yunchencui-hub/DT-smart-system/video-remotion/review/anatomy-script.md

# Review copy of the Robin anatomy + ELI5 build video (generated)

Generated by `scripts/review.ts --script anatomy` from the same data the video renders (`src/anatomy/script.ts`, `src/data/wiring.ts`). **Do not edit by hand.**
Each spoken line shows the cable state while it is spoken: 🔌 **USB OUT** (Arduino unplugged: the only state in which we wire), ⚡ **USB IN** (testing), 💽 **MICRO** (Arduino unplugged, voice module alone on its micro-USB cable).
"adds" = the parts or wires that appear on the workbench drawing during that line, with their exact holes.

## Build Robin: the anatomy, step by step  `a-title`
*Welcome*

1. [🔌 USB OUT] This is Robin, a small care robot. In this video we build it, one step at a time.
2. [🔌 USB OUT] Every picture is a drawing of the parts you received, and every part sits exactly where it goes on your bench.
3. [🔌 USB OUT] We follow the assembly guide, file 04, and for each step you hear what to do and why it works, in plain words.

On-screen text:
- `title`: Build Robin
- `sub`: The anatomy of the build, step by step · follows docs/04
- `badge`: DRAWING · not real footage

## What came in the box  `a-kit`
*1 · Get ready*

1. [🔌 USB OUT] First, check what you received. Tick off every part, and if something is missing, tell the store room before you start.
2. [🔌 USB OUT] Think of Robin as a body. The Arduino is the brain. It reads the sensors, and its grid of little lights is Robin's face.
3. [🔌 USB OUT] The motion sensor and the light sensor are its eyes. The two buttons are its ears: green means yes, red means no.
4. [🔌 USB OUT] The voice module and the speaker are its mouth. The breadboard and the jumper wires are its nerves: they connect everything.
5. [🔌 USB OUT] The capacitor is a small water tank for electricity. And the box with the clear lid is Robin's skin.
6. [🔌 USB OUT] Some parts come with a spare: two light sensors, two capacitors, two speakers, three buttons. Keep the spares in the bag.

On-screen text:
- `brain`: brain + face
- `senses`: eyes + ears
- `mouth`: mouth + nerves
- `tank`: water tank + skin
- `note`: Renders of the parts we received (video-assets/parts/)

## Three rules before you build  `a-rules`
*1 · Get ready*

1. [🔌 USB OUT] Before step one, upload the firmware in offline test mode, as in file 05. Then no WiFi is needed yet.
   - *spoken:* "Before step one, upload the firmware in offline test mode, as in file 05. Then no Wi-Fi is needed yet."
2. [🔌 USB OUT] Rule one, the golden rule: wire only while the USB cable is unplugged. Plug in only to test, and unplug again after every test.
   - *spoken:* "Rule one, the golden rule: wire only while the U S B cable is unplugged. Plug in only to test, and unplug again after every test."
3. [🔌 USB OUT] Rule two: work on cardboard or wood, never on metal or on your laptop. The pins under the boards are bare, and metal would connect them.
4. [🔌 USB OUT] Rule three: read the label, not the picture. Pin order can differ between versions of a module, so always go by the names printed on your own part.
5. [🔌 USB OUT] Three things have a plus and a minus, and do damage when they are reversed: the module's power pins, the capacitor, and the breadboard rails. Check them twice.
6. [🔌 USB OUT] After every step there is a test. Don't continue until it passes. One new mistake is easy to find. Six at once is misery.

Figure card: Fig 1 · The bench · readout: nothing wired yet

ELI5 card: Wire unplugged. Test plugged in. Unplug again.

## Inside the breadboard  `a-breadboard`
*1 · Get ready*

1. [🔌 USB OUT] Now the breadboard. It looks like a field of holes, but inside it is simple.
2. [🔌 USB OUT] Lift off the plastic, and you see metal clips. Each clip connects a few holes into one group.
3. [🔌 USB OUT] Each short column of five holes is one group. Two legs in the same group are connected.
   - *glows:* col:5:bottom
4. [🔌 USB OUT] The middle gap splits every column into a top half and a bottom half, and the two halves are not connected.
   - *glows:* col:5:bottom, col:5:top
5. [🔌 USB OUT] Along the long sides run the rails. Every hole along the red line is connected: that is the plus rail, 5 volts. Every hole along the blue line is the minus rail, ground.
   - *glows:* rail:+b, rail:-b
6. [🔌 USB OUT] The two pairs of rails are not connected to each other. We only use the pair next to the Arduino's power pins.
   - *glows:* rail:+b, rail:-b
7. [🔌 USB OUT] Some boards put the red line on the outside, others on the inside. Always follow the red and blue lines printed on your own board.
8. [🔌 USB OUT] If a line has a break in the middle, that rail is split in two. Join the halves with a short wire: plus to plus, minus to minus, never red to blue.

Figure card: Fig 2 · Breadboard, x-ray · hint: the plastic lifted off · readout: 30 columns · 4 rails

ELI5 card: Holes in the same metal clip are connected. Different clips are not.

## Step 1 · Power rails  `a-step1`
*2 · Build*

1. [🔌 USB OUT] Step one: power. The brain shares its power with the breadboard.
2. [🔌 USB OUT] With the USB cable unplugged, connect the Arduino's 5V pin to the plus rail, the red line.
   - *spoken:* "With the U S B cable unplugged, connect the Arduino's five volt pin to the plus rail, the red line."
   - *glows:* pin:5V, rail:+b
   - *adds* `w5v`: Arduino 5V → + rail. (M-M, red: Arduino 5V → + rail (col 2))
3. [🔌 USB OUT] Then connect GND to the minus rail, the blue line.
   - *spoken:* "Then connect G N D to the minus rail, the blue line."
   - *glows:* pin:GND, rail:-b
   - *adds* `wgnd`: Arduino GND → − rail. (M-M, black: Arduino GND → − rail (col 1))
4. [🔌 USB OUT] Now the whole red line carries 5 volts, and the whole blue line is ground. Every part can take its power there, like plugging into a power strip.
   - *glows:* rail:+b, rail:-b
5. [⚡ USB IN] Test: plug in the USB cable. The power LED comes on. The face shows crossed eyes for a moment while it starts, then a happy face.
   - *spoken:* "Test: plug in the U S B cable. The power L E D comes on. The face shows crossed eyes for a moment while it starts, then a happy face."
6. [🔌 USB OUT] Unplug.

Figure card: Fig 3 · Step 1 · Power

ELI5 card: The rails are a power strip: every part can plug in there.

Parts shown (renders): dupont_mm_200mm

## Step 2 · Light sensor (LDR)  `a-step2`
*2 · Build*

1. [🔌 USB OUT] Step two: the light sensor, Robin's eye for light.
2. [🔌 USB OUT] The Arduino can't measure resistance. It can only measure voltage. So we build a voltage divider.
3. [🔌 USB OUT] Push one leg of the LDR into the plus rail, and the other leg into column 5, in the bottom half.
   - *spoken:* "Push one leg of the L D R into the plus rail, and the other leg into column five, in the bottom half."
   - *glows:* rail:+b, col:5:bottom
   - *adds* `ldr`: LDR: one leg in the + rail, the other in column 5 (bottom half). (a: + rail (col 3); b: column 5, row i)
4. [🔌 USB OUT] Which resistor is 10 kΩ? Read the label on its bag. Keep the 1 kΩ bag closed for now.
   - *spoken:* "Which resistor is ten kilo-ohm? Read the label on its bag. Keep the one kilo-ohm bag closed for now."
5. [🔌 USB OUT] Put the 10 kΩ resistor from column 5 to the minus rail. The LDR and the resistor have no plus or minus, so either way round is fine.
   - *spoken:* "Put the ten kilo-ohm resistor from column five to the minus rail. The L D R and the resistor have no plus or minus, so either way round is fine."
   - *glows:* col:5:bottom, rail:-b
   - *adds* `r10k`: 10 kΩ: one leg in column 5, the other in the − rail. (a: column 5, row g; b: − rail (col 9))
6. [🔌 USB OUT] Then a wire from column 5 to the Arduino's A0 pin.
   - *spoken:* "Then a wire from column five to the Arduino's A zero pin."
   - *glows:* col:5:bottom, pin:A0
   - *adds* `wA0`: column 5 → Arduino A0. (M-M, yellow: column 5, row f (bottom half) → Arduino A0)
7. [🔌 USB OUT] Why this works: the LDR and the resistor share the 5 volts, and the bigger one takes the bigger share. In the dark the LDR is huge, so A0 sees almost nothing. In light the LDR shrinks, and A0 rises.
   - *spoken:* "Why this works: the L D R and the resistor share the 5 volts, and the bigger one takes the bigger share. In the dark the L D R is huge, so A zero sees almost nothing. In light the L D R shrinks, and A zero rises."
   - *glows:* col:5:bottom
8. [🔌 USB OUT] Predict: when you cover the LDR with your finger, does light_raw go up, or down?
   - *spoken:* "Predict: when you cover the L D R with your finger, does light raw go up, or down?"
9. [🔌 USB OUT] ⏸ pause 2.5 s: Predict: cover the LDR → light_raw goes up or down?
10. [⚡ USB IN] Test: plug in, open the Serial Monitor at 115200 baud, type raw and press Enter.
   - *spoken:* "Test: plug in, open the Serial Monitor at one hundred fifteen thousand two hundred baud, type raw and press Enter."
   - *Serial Monitor shows:* `> raw` · `[cmd] raw` · `pir_raw=4 (HIGH if > 400)  light_raw=431  yes=-  no=-` · `pir_raw=3 (HIGH if > 400)  light_raw=428  yes=-  no=-`
11. [⚡ USB IN] Cover the LDR: light_raw drops a lot. Shine your phone torch on it: it rises. So the answer was: down.
   - *spoken:* "Cover the L D R: light raw drops a lot. Shine your phone torch on it: it rises. So the answer was: down."
   - *Serial Monitor shows:* `pir_raw=5 (HIGH if > 400)  light_raw=38  yes=-  no=-` · `pir_raw=4 (HIGH if > 400)  light_raw=31  yes=-  no=-` · `pir_raw=3 (HIGH if > 400)  light_raw=874  yes=-  no=-` · `pir_raw=4 (HIGH if > 400)  light_raw=902  yes=-  no=-`
12. [🔌 USB OUT] Unplug.

Figure card: Fig 4 · Step 2 · Light

ELI5 card: Two resistors share 5 volts. The bigger one takes the bigger share.

Parts shown (renders): ldr_gl5528, resistor_10k_quarter_watt, dupont_mm_200mm

## Step 3 · PIR motion sensor  `a-step3`
*2 · Build*

1. [🔌 USB OUT] Step three: the motion sensor, Robin's eye for movement. It notices warm bodies that move.
2. [🔌 USB OUT] Gently pull off the white dome to read the pin labels: VCC, OUT and GND. Then put the dome back.
   - *spoken:* "Gently pull off the white dome to read the pin labels: V C C, OUT and G N D. Then put the dome back."
3. [🔌 USB OUT] On your board the order may be different. Go by the labels you read there, not by this drawing.
4. [🔌 USB OUT] On the back are two knobs. Turn the time knob, Tx, fully counter-clockwise: the shortest time, about 3 seconds.
   - *spoken:* "On the back are two knobs. Turn the time knob, T x, fully counter-clockwise: the shortest time, about three seconds."
   - *adds* `pir`: PIR motion sensor (HC-SR501), off the board. (off the breadboard)
5. [🔌 USB OUT] Set the sensitivity knob, Sx, to the middle. If there is a jumper, put it on H, so the output stays high while you keep moving.
   - *spoken:* "Set the sensitivity knob, S x, to the middle. If there is a jumper, put it on H, so the output stays high while you keep moving."
6. [🔌 USB OUT] Knobs not labelled? Turn both fully counter-clockwise, then turn one back to the middle. If pir_raw stays high for minutes in the test, unplug and swap them.
   - *spoken:* "Knobs not labelled? Turn both fully counter-clockwise, then turn one back to the middle. If P I R raw stays high for minutes in the test, unplug and swap them."
7. [🔌 USB OUT] Now three male to female wires: the female end goes onto the PIR pin, the male end into the breadboard or the Arduino.
   - *spoken:* "Now three male to female wires: the female end goes onto the P I R pin, the male end into the breadboard or the Arduino."
8. [🔌 USB OUT] VCC to the plus rail.
   - *spoken:* "V C C to the plus rail."
   - *glows:* rail:+b
   - *adds* `wPV`: PIR VCC → + rail. (F-M, red: PIR VCC → + rail (col 29))
9. [🔌 USB OUT] GND to the minus rail.
   - *spoken:* "G N D to the minus rail."
   - *glows:* rail:-b
   - *adds* `wPG`: PIR GND → − rail. (F-M, black: PIR GND → − rail (col 30))
10. [🔌 USB OUT] And OUT to A1.
   - *spoken:* "And OUT to A one."
   - *glows:* pin:A1
   - *adds* `wPO`: PIR OUT → Arduino A1. (F-M, orange: PIR OUT → Arduino A1)
11. [🔌 USB OUT] Why A1, an analog pin? The PIR says yes with 3.3 volts. On a digital pin the Arduino only reliably hears a yes above about 3.5 volts, so 3.3 volts is a whisper it might miss.
   - *spoken:* "Why A one, an analog pin? The P I R says yes with three point three volts. On a digital pin the Arduino only reliably hears a yes above about 3.5 volts, so three point three volts is a whisper it might miss."
   - *glows:* pin:A1
12. [🔌 USB OUT] On an analog pin, 3.3 volts reads as about 675 out of 1023, far above our threshold of 400.
   - *spoken:* "On an analog pin, three point three volts reads as about six hundred and seventy-five out of ten twenty-three, far above our threshold of four hundred."
   - *glows:* pin:A1
13. [⚡ USB IN] Test: plug in and wait 60 seconds. A PIR has to warm up, and gives random output at first.
   - *spoken:* "Test: plug in and wait sixty seconds. A P I R has to warm up, and gives random output at first."
   - *Serial Monitor shows:* `> raw` · `[cmd] raw`
14. [⚡ USB IN] Type raw. Sit still, and pir_raw is about 0. Wave, and it is about 650 to 700.
   - *spoken:* "Type raw. Sit still, and P I R raw is about zero. Wave, and it is about six hundred and fifty to seven hundred."
   - *Serial Monitor shows:* `pir_raw=3 (HIGH if > 400)  light_raw=433  yes=-  no=-` · `pir_raw=2 (HIGH if > 400)  light_raw=430  yes=-  no=-` · `pir_raw=671 (HIGH if > 400)  light_raw=431  yes=-  no=-` · `pir_raw=668 (HIGH if > 400)  light_raw=429  yes=-  no=-`
15. [🔌 USB OUT] Unplug.

Figure card: Fig 5 · Step 3 · Motion

ELI5 card: It notices warm bodies that move, and says "yes" with 3.3 volts.

Parts shown (renders): hc_sr501_pir, dupont_mf_200mm

## Step 4 · Yes and no buttons  `a-step4`
*2 · Build*

1. [🔌 USB OUT] Step four: the yes and no buttons, Robin's ears.
2. [🔌 USB OUT] A button has four legs, but only two connections: inside, the legs are joined in two pairs. This trips most people up.
3. [🔌 USB OUT] The trick that always works: put the button across the middle gap, and use two diagonally opposite legs.
4. [🔌 USB OUT] Press the green button in across the gap: its legs land in columns 11 and 13, rows d and g. Press firmly. If a leg won't go in, straighten it gently with pliers.
   - *spoken:* "Press the green button in across the gap: its legs land in columns eleven and thirteen, rows d and g. Press firmly. If a leg won't go in, straighten it gently with pliers."
   - *adds* `btnG`: green (YES) button across the gap, legs in columns 11 and 13. (tl: column 11, row d; tr: column 13, row d; bl: column 11, row g; br: column 13, row g)
5. [🔌 USB OUT] A wire from column 11, top half, to the Arduino's D2 pin.
   - *spoken:* "A wire from column eleven, top half, to the Arduino's D two pin."
   - *glows:* col:11:top, pin:D2
   - *adds* `wD2`: column 11 (top half) → Arduino D2. (M-M, green: column 11, row b (top half) → Arduino D2)
6. [🔌 USB OUT] From the diagonally opposite leg, column 13 in the bottom half, a wire to the minus rail.
   - *spoken:* "From the diagonally opposite leg, column thirteen in the bottom half, a wire to the minus rail."
   - *glows:* col:13:bottom, rail:-b
   - *adds* `wGG`: column 13 (bottom half, the diagonal leg) → − rail. (M-M, black: column 13, row i (bottom half) → − rail (col 14))
7. [🔌 USB OUT] The red button goes in columns 17 and 19: column 17, top half, to D3. Column 19, bottom half, to the minus rail.
   - *spoken:* "The red button goes in columns seventeen and nineteen: column seventeen, top half, to D three. Column nineteen, bottom half, to the minus rail."
   - *glows:* pin:D3
   - *adds* `btnR`: red (NO) button across the gap, legs in columns 17 and 19. (tl: column 17, row d; tr: column 19, row d; bl: column 17, row g; br: column 19, row g)
   - *adds* `wD3`: column 17 (top half) → Arduino D3. (M-M, purple: column 17, row b (top half) → Arduino D3)
   - *adds* `wGR`: column 19 (bottom half, the diagonal leg) → − rail. (M-M, black: column 19, row i (bottom half) → − rail (col 20))
8. [🔌 USB OUT] A button never goes to the plus rail: only to the minus rail and a D pin. Then put the caps on.
   - *glows:* rail:-b
9. [🔌 USB OUT] Why: inside the Arduino, a pull-up resistor keeps the pin at 5 volts, a HIGH, while nobody presses. Pressing connects the pin to ground, so it reads LOW. It looks backwards, but it saves a resistor.
   - *glows:* pin:D2,D3
10. [🔌 USB OUT] Predict: while you hold the green button, does D2 read HIGH, or LOW?
   - *spoken:* "Predict: while you hold the green button, does D two read HIGH, or LOW?"
11. [🔌 USB OUT] ⏸ pause 2.5 s: Predict: green held → D2 reads HIGH or LOW?
12. [⚡ USB IN] Test: plug in and type raw. While you hold green, it shows yes equals pressed: the pin reads LOW.
   - *Serial Monitor shows:* `> raw` · `[cmd] raw` · `pir_raw=2 (HIGH if > 400)  light_raw=430  yes=-  no=-` · `pir_raw=3 (HIGH if > 400)  light_raw=431  yes=pressed  no=-`
13. [⚡ USB IN] Pressing also shows a tick or a cross on the face, and the Serial Monitor prints button yes, or button no.
   - *Serial Monitor shows:* `[button] yes` · `[button] no`
14. [🔌 USB OUT] Unplug.

Figure card: Fig 6 · Step 4 · Buttons

ELI5 card: Pressed connects the pin to ground: pressed reads LOW.

Parts shown (renders): tactile_switch_with_green_cap, tactile_switch_with_red_cap, dupont_mm_200mm

## Step 5a · The speaker (the only soldering)  `a-step5a`
*2 · Build*

1. [🔌 USB OUT] Step five is the voice, in four parts: the speaker, the sound files, the wiring, and the capacitor.
2. [🔌 USB OUT] Part a, the speaker. This is the only soldering in the project: two joints.
3. [🔌 USB OUT] Safety glasses on. Solder at Pulsed with the iron in its stand, in a ventilated spot. Hold the wire with tape, not your fingers. Never touch the tip, and if the iron falls, let it fall.
4. [🔌 USB OUT] The speaker set has two speakers, and their four wires end in one white plug. Cut the wires right behind the plug.
5. [🔌 USB OUT] Careful: that four-pin plug also fits the voice module's Gravity socket. Never plug it in there. Cut it off.
6. [🔌 USB OUT] Follow the wires back to find the two that belong to the speaker you will use. Never connect both speakers. Tape each bare end of the spare separately.
7. [🔌 USB OUT] Here is the voice module, the DFR0534, lying flat on the table.
   - *spoken:* "Here is the voice module, the D F R zero five three four, lying flat on the table."
   - *adds* `voice`: DFR0534 voice module, off the board, lying flat away from the Arduino. (off the breadboard)
8. [🔌 USB OUT] Strip 5 millimetres of your speaker's two wires and twist the strands.
   - *spoken:* "Strip five millimetres of your speaker's two wires and twist the strands."
   - *adds* `spk`: one speaker of the 2 W set (the other is a spare with taped wire ends). (off the breadboard)
9. [🔌 USB OUT] Solder them into the SP+ and SP− holes, at the end of the row that starts with ONE. Red goes to SP+.
   - *spoken:* "Solder them into the S P plus and S P minus holes, at the end of the row that starts with ONE. Red goes to S P plus."
   - *glows:* vhole:SP+,SP−
   - *adds* `wSPp`: speaker + (red) → DFR0534 SP+ hole (bottom row, last; soldered in step 5a). (speaker wire, red: speaker + → DFR0534 SP+)
   - *adds* `wSPm`: speaker − (black) → DFR0534 SP− hole (bottom row, next to SP+; soldered in step 5a). (speaker wire, black: speaker − → DFR0534 SP−)
10. [🔌 USB OUT] No solder may reach the next hole, DACL, or join SP+ to SP−. Never solder the speaker to VCC, GND, RX, TX, BUSY or a DAC hole.
   - *spoken:* "No solder may reach the next hole, D A C L, or join S P plus to S P minus. Never solder the speaker to V C C, G N D, R X, T X, busy, or a D A C hole."
   - *glows:* vhole:SP+,SP−
11. [🔌 USB OUT] If your module has pins there instead of holes, use a cut female to female jumper, as file 04 shows.
12. [🔌 USB OUT] Tape both wires down about 2 centimetres from the joints. Then switch the iron off, and wash your hands.

Figure card: Fig 7 · Step 5a · Speaker

ELI5 card: The voice module is the mouth; the speaker is its lips.

Parts shown (renders): dfrobot_dfr0534, speaker_set_with_cable

## Step 5b · Robin's voice files  `a-step5b`
*2 · Build*

1. [🔌 USB OUT] Part b: Robin's voice. The module stores its sentences in its own memory.
2. [🔌 USB OUT] Keep the Gravity cable out of the module for now. Otherwise the laptop's USB and the Arduino's 5 volts would be connected together.
   - *spoken:* "Keep the Gravity cable out of the module for now. Otherwise the laptop's U S B and the Arduino's 5 volts would be connected together."
3. [💽 MICRO] Connect the module to the laptop with the micro-USB data cable. It shows up as a small USB drive.
   - *spoken:* "Connect the module to the laptop with the micro U S B data cable. It shows up as a small U S B drive."
4. [💽 MICRO] Delete any demo files on it. Copy 01.mp3 to 13.mp3 from audio/en into the root of the drive.
   - *spoken:* "Delete any demo files on it. Copy zero one dot M P 3 to thirteen dot M P 3 from audio slash E N into the root of the drive."
5. [🔌 USB OUT] Eject the drive safely, and unplug the micro-USB cable.
   - *spoken:* "Eject the drive safely, and unplug the micro U S B cable."

On-screen text:
- `drive`: DFR0534 (USB drive)
- `files`: 01.mp3 … 13.mp3 in the root
- `warn`: Gravity cable OUT while the micro-USB is in

## Step 5c · Voice module wiring  `a-step5c`
*2 · Build*

1. [🔌 USB OUT] Part c: wire the voice module, with the USB cable unplugged.
   - *spoken:* "Part c: wire the voice module, with the U S B cable unplugged."
2. [🔌 USB OUT] Push the Gravity cable's white plug into the module's white socket. It fits one way only.
   - *adds* `grav`: Gravity cable: its white plug into the module's white Gravity socket, 4 female sockets at the other end. (off the breadboard)
3. [🔌 USB OUT] Push a male to male wire fully into each of the cable's four female sockets, so no bare metal shows.
4. [🔌 USB OUT] Follow each wire back to the module, and read the label next to its pin: plus, minus, T and R. Put a small tape flag with that letter on each wire. Don't trust the wire colours.
5. [🔌 USB OUT] Extra check, recommended: with a multimeter set to beep, the wire flagged plus must beep steadily with the VCC hole, and the wire flagged minus with GND.
   - *spoken:* "Extra check, recommended: with a multimeter set to beep, the wire flagged plus must beep steadily with the V C C hole, and the wire flagged minus with G N D."
6. [🔌 USB OUT] Plus goes to the plus rail, minus goes to the minus rail.
   - *glows:* rail:+b, rail:-b
   - *adds* `wVp`: cable socket "+" → + rail. (M-M, red: Gravity cable socket "+" → + rail (col 27))
   - *adds* `wVm`: cable socket "−" → − rail. (M-M, black: Gravity cable socket "−" → − rail (col 26))
7. [🔌 USB OUT] Predict: the module's T means "I talk". Does it go to the Arduino's RX pin, or its TX pin?
   - *spoken:* "Predict: the module's T means "I talk". Does it go to the Arduino's R X pin, or its T X pin?"
   - *glows:* pin:D0,D1
8. [🔌 USB OUT] ⏸ pause 2.5 s: Predict: module T → Arduino RX (D0) or TX (D1)?
9. [🔌 USB OUT] T goes to D0, the Arduino's RX: its ear.
   - *spoken:* "T goes to D zero, the Arduino's R X: its ear."
   - *glows:* pin:D0
   - *adds* `wT`: cable socket "T" (module talks) → Arduino D0 (RX). (M-M, blue: Gravity cable socket "T" → Arduino D0)
10. [🔌 USB OUT] R goes to column 22, top half. The 1 kΩ resistor goes from column 22 to column 26, and a wire from column 26 goes to D1, the Arduino's TX: its mouth.
   - *spoken:* "R goes to column twenty-two, top half. The one kilo-ohm resistor goes from column twenty-two to column twenty-six, and a wire from column twenty-six goes to D one, the Arduino's T X: its mouth."
   - *glows:* col:22:top, col:26:top, pin:D1
   - *adds* `wR`: cable socket "R" (module listens) → column 22 (top half). (M-M, teal: Gravity cable socket "R" → column 22, row b (top half))
   - *adds* `r1k`: 1 kΩ from column 22 to column 26 (top half). (a: column 22, row d; b: column 26, row d)
   - *adds* `wD1`: column 26 (top half) → Arduino D1 (TX). (M-M, pink: column 26, row b (top half) → Arduino D1)
11. [🔌 USB OUT] T means I talk, R means I listen. One device's mouth goes to the other's ear, so they cross. The 1 kΩ resistor limits the current from the Arduino's 5 volt signal into the module's input.
   - *spoken:* "T means I talk, R means I listen. One device's mouth goes to the other's ear, so they cross. The one kilo-ohm resistor limits the current from the Arduino's five volt signal into the module's input."
   - *glows:* pin:D0,D1
12. [🔌 USB OUT] Lay the module flat on the table, away from the Arduino, so its pins can't touch anything. A piece of tape holds it in place.

Figure card: Fig 8 · Step 5c · Voice wiring

ELI5 card: One device's mouth goes to the other's ear, so T and R cross.

Parts shown (renders): dfrobot_gravity_cable, dupont_mm_200mm, resistor_1k_quarter_watt

## Step 5d · The capacitor (polarity!)  `a-step5d`
*2 · Build*

1. [🔌 USB OUT] Part d: the capacitor, Robin's small water tank.
2. [🔌 USB OUT] When Robin speaks loudly, the speaker suddenly gulps current and the 5 volts dips. You hear pops, or the Arduino even restarts. The capacitor sits next to the module and covers those gulps.
3. [🔌 USB OUT] It has a plus and a minus. The minus leg is under the light stripe with minus signs, and it is the shorter leg.
4. [🔌 USB OUT] Predict: which leg goes into the minus rail?
5. [🔌 USB OUT] ⏸ pause 2.5 s: Predict: which leg goes into the − rail?
6. [🔌 USB OUT] The striped, short leg goes into the minus rail, the blue line. The long leg goes into the plus rail, next to where the module's wires go in.
   - *glows:* rail:-b, rail:+b
   - *adds* `cap`: 680 µF capacitor: long + leg in the + rail, striped − leg in the − rail. (plus: + rail (col 22); minus: − rail (col 24))
7. [🔌 USB OUT] Its legs are 5 millimetres apart, so put them a column or two apart, or bend them gently to fit.
   - *spoken:* "Its legs are five millimetres apart, so put them a column or two apart, or bend them gently to fit."
8. [🔌 USB OUT] Backwards is dangerous for the part: a reversed capacitor gets warm, bulges, or pops open. If one ever gets warm or bulges, unplug, leave it for ten minutes without touching it, and fit the spare the right way round.
9. [🔌 USB OUT] Before you plug in, check: the stripe is in the minus rail. Module plus in the plus rail, minus in the minus rail. T to D0, and R through the 1 kΩ resistor to D1.
   - *spoken:* "Before you plug in, check: the stripe is in the minus rail. Module plus in the plus rail, minus in the minus rail. T to D zero, and R through the one kilo-ohm resistor to D one."
   - *glows:* rail:-b, rail:+b
10. [🔌 USB OUT] The speaker wires are in SP+ and SP− and nothing else, the spare's ends are taped, and no bare metal touches anything.
   - *spoken:* "The speaker wires are in S P plus and S P minus and nothing else, the spare's ends are taped, and no bare metal touches anything."
   - *glows:* vhole:SP+,SP−
11. [⚡ USB IN] Plug in, with your face away from the capacitor. After about 2 seconds, Robin says hello.
   - *spoken:* "Plug in, with your face away from the capacitor. After about two seconds, Robin says hello."
12. [⚡ USB IN] 🤖 Robin plays its own clip audio/en/01.mp3
13. [⚡ USB IN] Type say 3, and you hear the medicine question.
   - *spoken:* "Type say three, and you hear the medicine question."
   - *Serial Monitor shows:* `> say 3` · `[cmd] say 3`
14. [⚡ USB IN] 🤖 Robin plays its own clip audio/en/03.mp3
15. [⚡ USB IN] Too loud? Type vol 15. Stay at vol 22 or lower, so the small speaker doesn't distort.
   - *spoken:* "Too loud? Type vol fifteen. Stay at vol twenty-two or lower, so the small speaker doesn't distort."
   - *Serial Monitor shows:* `> vol 15` · `[cmd] vol 15`
16. [🔌 USB OUT] Unplug.

Figure card: Fig 9 · Step 5d · Capacitor

ELI5 card: A small water tank next to the mouth, for the loud words.

Parts shown (renders): aishi_680uf_25v

## Step 6 · Faces  `a-step6`
*2 · Build*

1. [⚡ USB IN] Step six: faces. Plug in.
2. [⚡ USB IN] Type face ask.
   - *Serial Monitor shows:* `> face ask` · `[cmd] face ask`
3. [⚡ USB IN] Face concern.
   - *Serial Monitor shows:* `> face concern` · `[cmd] face concern`
4. [⚡ USB IN] Face sleep.
   - *Serial Monitor shows:* `> face sleep` · `[cmd] face sleep`
5. [⚡ USB IN] And face happy. The happy face blinks every few seconds, like Tessa's eyes.
   - *Serial Monitor shows:* `> face happy` · `[cmd] face happy`
6. [🔌 USB OUT] Unplug.

Figure card: Fig 10 · Step 6 · Faces

ELI5 card: 96 little lights, 12 by 8: Robin's face.

## Step 7 · Go online  `a-step7`
*2 · Build*

1. [🔌 USB OUT] Step seven: go online. Only now, fill in arduino_secrets.h with your hotspot's name and password and your laptop's IP address, and start Mosquitto. File 05, part C, shows how.
   - *spoken:* "Step seven: go online. Only now, fill in arduino secrets dot h with your hotspot's name and password and your laptop's I P address, and start Mosquitto. File 05, part C, shows how."
2. [⚡ USB IN] Plug in and upload the sketch again.
3. [⚡ USB IN] Test: the face changes from crossed eyes to a happy face, and mosquitto_sub shows Robin's messages.
   - *spoken:* "Test: the face changes from crossed eyes to a happy face, and mosquitto sub shows Robin's messages."
   - *Serial Monitor shows:* `$ mosquitto_sub -t "robin/#" -v` · `robin/robin-01/status online` · `robin/robin-01/telemetry {"boot":1,"seq":4,…` · `  …,"pir":0,"edges":0,"high_ms":0,"light":431,…}`
4. [🔌 USB OUT] Unplug before step eight.

Figure card: Fig 11 · Step 7 · Online

ELI5 card: Robin posts its senses to the laptop, like letters to a mailbox.

## Step 8 · The body  `a-step8`
*2 · Build*

1. [🔌 USB OUT] Step eight: the body. The Kradex box comes apart into a grey base, a rubber seal, the clear lid, six screws and six small plugs.
2. [🔌 USB OUT] Drill first, build in after: make every hole while the box is still empty. Clamp the box, never hold it in your hand, wear safety glasses, and use a step drill at Pulsed.
3. [🔌 USB OUT] The clear lid is the face: the LED matrix sits right behind it. Drill a 23 to 24 millimetre hole in the lid for the PIR dome.
   - *spoken:* "The clear lid is the face: the L E D matrix sits right behind it. Drill a twenty-three to twenty-four millimetre hole in the lid for the P I R dome."
4. [🔌 USB OUT] Six to eight small holes on the side for the speaker, a notch at the back for the USB cable, and one 10 millimetre hole in the top for the button and LDR wires. Remove the plastic burrs with a file.
   - *spoken:* "Six to eight small holes on the side for the speaker, a notch at the back for the U S B cable, and one 10 millimetre hole in the top for the button and L D R wires. Remove the plastic burrs with a file."
5. [🔌 USB OUT] Glue the speaker behind its holes with a few dots of hot glue on its rim, never on the paper cone. Hot glue and the nozzle burn: keep the gun on its stand, and let the glue cool. Tape the voice module down, so its pins can't touch the Arduino.
6. [🔌 USB OUT] Moving everything into the box means re-plugging wires. So afterwards, do the step five check again, then the tests: raw, say 3, and the faces.
   - *spoken:* "Moving everything into the box means re-plugging wires. So afterwards, do the step five check again, then the tests: raw, say three, and the faces."
7. [🔌 USB OUT] Put a cable tie on the USB cable just inside the notch, so a pull on the cable doesn't drag the Arduino.
   - *spoken:* "Put a cable tie on the U S B cable just inside the notch, so a pull on the cable doesn't drag the Arduino."
8. [🔌 USB OUT] At home, power Robin from an undamaged, CE-marked phone charger. Lay the cable where nobody trips over it, and don't cover the box. If the box ever feels warm, unplug it.
   - *spoken:* "At home, power Robin from an undamaged, C E-marked phone charger. Lay the cable where nobody trips over it, and don't cover the box. If the box ever feels warm, unplug it."

Figure card: Fig 12 · Step 8 · Body

ELI5 card: The box is Robin's skin. The clear lid is its face.

Parts shown (renders): kradex_z74_base, kradex_z74_gasket, kradex_z74_lid, kradex_z74_cover_screw

## That's Robin  `a-end`
*3 · Wrap-up*

1. [🔌 USB OUT] That's Robin, built step by step: power, light, motion, buttons, voice, faces, network, and body.
2. [🔌 USB OUT] Remember the golden rule: wire unplugged, test plugged in, then unplug again.
3. [🔌 USB OUT] These pictures are drawings that explain. The proof of your build is your own photos and clips, in the real build video.

On-screen text:
- `recap`: power · light · motion · buttons · voice · faces · online · body
- `rule`: Wire unplugged → test plugged in → unplug

## Tables shown on screen

### Pin map (= docs/04)
| From | To | Wire |
|---|---|---|
| Arduino 5V | breadboard + rail (red line) | M-M (red if you have it) |
| Arduino GND | breadboard − rail (blue line) | M-M (black) |
| LDR leg 1 | + rail | (the leg itself) |
| LDR leg 2 and 10 kΩ leg 1 | same column, bottom half, e.g. column 5 |  |
| 10 kΩ leg 2 | − rail |  |
| column 5 | Arduino A0 | M-M |
| PIR VCC | + rail | F-M |
| PIR GND | − rail | F-M |
| PIR OUT | Arduino A1 | F-M |
| YES button (green), across the middle gap (columns 11 and 13) | one leg's column to the − rail, the diagonally opposite leg's column to Arduino D2 | 2× M-M |
| NO button (red), across the middle gap (columns 17 and 19) | one leg's column to the − rail, diagonal leg's column to Arduino D3 | 2× M-M |
| DFR0534 white Gravity socket (T, R, −, +) | the 4-wire cable that comes with the module: its white plug goes in here; its other end has 4 female sockets | (the cable) |
| cable wire at socket pin + | + rail | M-M |
| cable wire at socket pin − | − rail | M-M |
| cable wire at socket pin T (module talks) | Arduino D0 (RX, Arduino listens) | M-M |
| cable wire at socket pin R (module listens) | column 22, top half; 1 kΩ from column 22 to column 26; column 26 → Arduino D1 (TX) | M-M + resistor + M-M |
| 680 µF capacitor | long leg (+) in the + rail, striped leg (−) in the − rail, next to the module's + and − wires | its own legs |
| DFR0534 SP+ / SP− holes (bottom row, next to DACL) | the two wires of one speaker from the set (never the SPK socket) | soldered (step 5a) |

### Every part and wire on the workbench drawing
| id | step | what | where exactly |
|---|---|---|---|
| w5v | 1 | Arduino 5V → + rail | M-M, red: Arduino 5V → + rail (col 2) |
| wgnd | 1 | Arduino GND → − rail | M-M, black: Arduino GND → − rail (col 1) |
| ldr | 2 | LDR: one leg in the + rail, the other in column 5 (bottom half) | a: + rail (col 3); b: column 5, row i |
| r10k | 2 | 10 kΩ: one leg in column 5, the other in the − rail | a: column 5, row g; b: − rail (col 9) |
| wA0 | 2 | column 5 → Arduino A0 | M-M, yellow: column 5, row f (bottom half) → Arduino A0 |
| pir | 3 | PIR motion sensor (HC-SR501), off the board | off the breadboard |
| wPV | 3 | PIR VCC → + rail | F-M, red: PIR VCC → + rail (col 29) |
| wPG | 3 | PIR GND → − rail | F-M, black: PIR GND → − rail (col 30) |
| wPO | 3 | PIR OUT → Arduino A1 | F-M, orange: PIR OUT → Arduino A1 |
| btnG | 4 | green (YES) button across the gap, legs in columns 11 and 13 | tl: column 11, row d; tr: column 13, row d; bl: column 11, row g; br: column 13, row g |
| wD2 | 4 | column 11 (top half) → Arduino D2 | M-M, green: column 11, row b (top half) → Arduino D2 |
| wGG | 4 | column 13 (bottom half, the diagonal leg) → − rail | M-M, black: column 13, row i (bottom half) → − rail (col 14) |
| btnR | 4 | red (NO) button across the gap, legs in columns 17 and 19 | tl: column 17, row d; tr: column 19, row d; bl: column 17, row g; br: column 19, row g |
| wD3 | 4 | column 17 (top half) → Arduino D3 | M-M, purple: column 17, row b (top half) → Arduino D3 |
| wGR | 4 | column 19 (bottom half, the diagonal leg) → − rail | M-M, black: column 19, row i (bottom half) → − rail (col 20) |
| voice | 5 | DFR0534 voice module, off the board, lying flat away from the Arduino | off the breadboard |
| spk | 5 | one speaker of the 2 W set (the other is a spare with taped wire ends) | off the breadboard |
| wSPp | 5 | speaker + (red) → DFR0534 SP+ hole (bottom row, last; soldered in step 5a) | speaker wire, red: speaker + → DFR0534 SP+ |
| wSPm | 5 | speaker − (black) → DFR0534 SP− hole (bottom row, next to SP+; soldered in step 5a) | speaker wire, black: speaker − → DFR0534 SP− |
| grav | 5 | Gravity cable: its white plug into the module's white Gravity socket, 4 female sockets at the other end | off the breadboard |
| wVp | 5 | cable socket "+" → + rail | M-M, red: Gravity cable socket "+" → + rail (col 27) |
| wVm | 5 | cable socket "−" → − rail | M-M, black: Gravity cable socket "−" → − rail (col 26) |
| wT | 5 | cable socket "T" (module talks) → Arduino D0 (RX) | M-M, blue: Gravity cable socket "T" → Arduino D0 |
| wR | 5 | cable socket "R" (module listens) → column 22 (top half) | M-M, teal: Gravity cable socket "R" → column 22, row b (top half) |
| r1k | 5 | 1 kΩ from column 22 to column 26 (top half) | a: column 22, row d; b: column 26, row d |
| wD1 | 5 | column 26 (top half) → Arduino D1 (TX) | M-M, pink: column 26, row b (top half) → Arduino D1 |
| cap | 5 | 680 µF capacitor: long + leg in the + rail, striped − leg in the − rail | plus: + rail (col 22); minus: − rail (col 24) |

Drawing notes: the breadboard is drawn with the rail pair next to the Arduino as − inside, + outside, as printed on the drawn board; the video says to follow the red/blue lines printed on the real board. The top rail pair is unused. Modules (PIR, DFR0534, speaker) lie off the board. The DFR0534 is drawn after the board photo in its datasheet (page 2, Voice Module V1.0): Gravity socket T R − + on the left, top holes VCC GND RX TX BUSY, bottom holes ONE DACR DACL SP− SP+, SPK socket on the right. The video says to go by the printed labels.

## Automatic checks

**Netcheck: 369/369 checks passed.**

- ✅ 5V and GND are never connected (no short circuit)
- ✅ + rail = 5V, − rail = GND
- ✅ the other rail pair stays unused
- ✅ A0 is never tied straight to 5V
- ✅ A0 and A1 are separate (except both on GND when both buttons are pressed)
- ✅ A0 and D0 are separate (except both on GND when both buttons are pressed)
- ✅ A0 and D1 are separate (except both on GND when both buttons are pressed)
- ✅ A0 and D2 are separate (except both on GND when both buttons are pressed)
- ✅ A0 and D3 are separate (except both on GND when both buttons are pressed)
- ✅ A1 is never tied straight to 5V
- ✅ A1 and D0 are separate (except both on GND when both buttons are pressed)
- ✅ A1 and D1 are separate (except both on GND when both buttons are pressed)
- ✅ A1 and D2 are separate (except both on GND when both buttons are pressed)
- ✅ A1 and D3 are separate (except both on GND when both buttons are pressed)
- ✅ D0 is never tied straight to 5V
- ✅ D0 and D1 are separate (except both on GND when both buttons are pressed)
- ✅ D0 and D2 are separate (except both on GND when both buttons are pressed)
- ✅ D0 and D3 are separate (except both on GND when both buttons are pressed)
- ✅ D1 is never tied straight to 5V
- ✅ D1 and D2 are separate (except both on GND when both buttons are pressed)
- ✅ D1 and D3 are separate (except both on GND when both buttons are pressed)
- ✅ D2 is never tied straight to 5V
- ✅ D2 and D3 are separate (except both on GND when both buttons are pressed)
- ✅ D3 is never tied straight to 5V
- ✅ D2 reaches GND exactly when green is pressed
- ✅ D3 reaches GND exactly when red is pressed
- ✅ LDR between 5V and A0
- ✅ 10 kΩ between A0 and GND
- ✅ PIR VCC→5V, GND→GND, OUT→A1
- ✅ DFR0534 + → 5V and − → GND (not reversed)
- ✅ DFR0534 T (talks) → D0 (RX)
- ✅ D1 (TX) reaches DFR0534 R only through the 1 kΩ
- ✅ capacitor + leg on 5V, striped − leg on GND
- ✅ one speaker on SP+ / SP−
- ✅ speaker outputs never touch 5V or GND
- ✅ hole 2+b used once (w5v)
- ✅ hole 1-b used once (wgnd)
- ✅ hole 3+b used once (ldr)
- ✅ hole 5i used once (ldr)
- ✅ hole 5g used once (r10k)
- ✅ hole 9-b used once (r10k)
- ✅ hole 5f used once (wA0)
- ✅ hole 29+b used once (wPV)
- ✅ hole 30-b used once (wPG)
- ✅ hole 11d used once (btnG)
- ✅ hole 13d used once (btnG)
- ✅ hole 11g used once (btnG)
- ✅ hole 13g used once (btnG)
- ✅ hole 11b used once (wD2)
- ✅ hole 13i used once (wGG)
- ✅ hole 14-b used once (wGG)
- ✅ hole 17d used once (btnR)
- ✅ hole 19d used once (btnR)
- ✅ hole 17g used once (btnR)
- ✅ hole 19g used once (btnR)
- ✅ hole 17b used once (wD3)
- ✅ hole 19i used once (wGR)
- ✅ hole 20-b used once (wGR)
- ✅ hole 27+b used once (wVp)
- ✅ hole 26-b used once (wVm)
- ✅ hole 22b used once (wR)
- ✅ hole 22d used once (r1k)
- ✅ hole 26d used once (r1k)
- ✅ hole 26b used once (wD1)
- ✅ hole 22+b used once (cap)
- ✅ hole 24-b used once (cap)
- ✅ 12 male-male wires used (ordered 30); got 12
- ✅ 3 female-male wires used (ordered 20); got 3
- ✅ firmware PIN_LIGHT = A0, and the light wire goes to A0
- ✅ firmware PIN_PIR = A1, and PIR OUT goes to A1
- ✅ firmware PIN_BTN_YES = 2, and the green button goes to D2
- ✅ firmware PIN_BTN_NO = 3, and the red button goes to D3
- ✅ firmware uses INPUT_PULLUP for the buttons (so they go to GND, never to 5V)
- ✅ firmware talks to the voice module on Serial1 = D0/D1
- ✅ pin map: 18 rows on screen, 18 in docs/04
- ✅ pin map row 1 matches docs/04: Arduino 5V
- ✅ pin map row 2 matches docs/04: Arduino GND
- ✅ pin map row 3 matches docs/04: LDR leg 1
- ✅ pin map row 4 matches docs/04: LDR leg 2 and 10 kΩ leg 1
- ✅ pin map row 5 matches docs/04: 10 kΩ leg 2
- ✅ pin map row 6 matches docs/04: column 5
- ✅ pin map row 7 matches docs/04: PIR VCC
- ✅ pin map row 8 matches docs/04: PIR GND
- ✅ pin map row 9 matches docs/04: PIR OUT
- ✅ pin map row 10 matches docs/04: YES button (green), across the middle gap (columns 11 and 13)
- ✅ pin map row 11 matches docs/04: NO button (red), across the middle gap (columns 17 and 19)
- ✅ pin map row 12 matches docs/04: DFR0534 white Gravity socket (T, R, −, +)
- ✅ pin map row 13 matches docs/04: cable wire at socket pin +
- ✅ pin map row 14 matches docs/04: cable wire at socket pin −
- ✅ pin map row 15 matches docs/04: cable wire at socket pin T (module talks)
- ✅ pin map row 16 matches docs/04: cable wire at socket pin R (module listens)
- ✅ pin map row 17 matches docs/04: 680 µF capacitor
- ✅ pin map row 18 matches docs/04: DFR0534 SP+ / SP− holes (bottom row, next to DACL)
- ✅ troubleshooting: 11 rows on screen, 11 in docs/04
- ✅ troubleshooting row 1 matches docs/04: Nothing in Serial Monitor
- ✅ troubleshooting row 2 matches docs/04: light_raw always ~0 or ~1023
- ✅ troubleshooting row 3 matches docs/04: pir_raw random HIGH/LOW
- ✅ troubleshooting row 4 matches docs/04: PIR stays HIGH ~minutes
- ✅ troubleshooting row 5 matches docs/04: Button always "pressed"
- ✅ troubleshooting row 6 matches docs/04: No sound
- ✅ troubleshooting row 7 matches docs/04: Plays the wrong sentence
- ✅ troubleshooting row 8 matches docs/04: Pops, buzzing, or the board resets when it talks loudly
- ✅ troubleshooting row 9 matches docs/04: Laptop says "USB device needs more power" or the port switches off when you plug in
- ✅ troubleshooting row 10 matches docs/04: Capacitor warm or bulging
- ✅ troubleshooting row 11 matches docs/04: ✗ eyes forever
- ✅ order total is €35.95 (got €35.95)
- ✅ the order has 16 lines (got 16)
- ✅ SKU 004047 (DFR0534 voice module (8 MB)) is in docs/03
- ✅ SKU 003415 (Speaker set 8 Ω 2 W (2 speakers)) is in docs/03
- ✅ SKU 000090 (HC-SR501 PIR motion sensor) is in docs/03
- ✅ SKU 003260 (Kradex box, clear lid) is in docs/03
- ✅ SKU 000759 (GL5528 LDR light sensor) is in docs/03
- ✅ SKU 001204 (Push button 12 × 12 mm) is in docs/03
- ✅ SKU 003060 (Button cap, green) is in docs/03
- ✅ SKU 003062 (Button cap, red) is in docs/03
- ✅ SKU 003058 (Button cap, white (spare)) is in docs/03
- ✅ SKU 000070 (Breadboard, 400 points) is in docs/03
- ✅ SKU 000164 (Jumper wires M-M, 10 per pack) is in docs/03
- ✅ SKU 000088 (Jumper wires M-F, 10 per pack) is in docs/03
- ✅ SKU 000089 (Jumper wires F-F, 10 per pack) is in docs/03
- ✅ SKU 007625 (Resistors 10 kΩ, 10 per bag) is in docs/03
- ✅ SKU 007621 (Resistors 1 kΩ, 10 per bag) is in docs/03
- ✅ SKU 006948 (Capacitor 680 µF 25 V) is in docs/03
- ✅ docs/03 shows €35.95 parts and €42.90 total

Wire ends: w5v Arduino 5V → + rail (col 2); wgnd Arduino GND → − rail (col 1); wA0 column 5, row f (bottom half) → Arduino A0; wPV PIR VCC → + rail (col 29); wPG PIR GND → − rail (col 30); wPO PIR OUT → Arduino A1; wD2 column 11, row b (top half) → Arduino D2; wGG column 13, row i (bottom half) → − rail (col 14); wD3 column 17, row b (top half) → Arduino D3; wGR column 19, row i (bottom half) → − rail (col 20); wSPp speaker + → DFR0534 SP+; wSPm speaker − → DFR0534 SP−; wVp Gravity cable socket "+" → + rail (col 27); wVm Gravity cable socket "−" → − rail (col 26); wT Gravity cable socket "T" → Arduino D0; wR Gravity cable socket "R" → column 22, row b (top half); wD1 column 26, row b (top half) → Arduino D1

**Cable-rule check: all passed** (R1 nothing wired or moved while plugged in · R2 every test ends unplugged · R3 micro-USB only with the Gravity cable off · R4 capacitor stripe checked before plug-in · R5 every item added once, in its own step).
