yunchencui-hub/DT-smart-system/aishi_680uf_25v.png

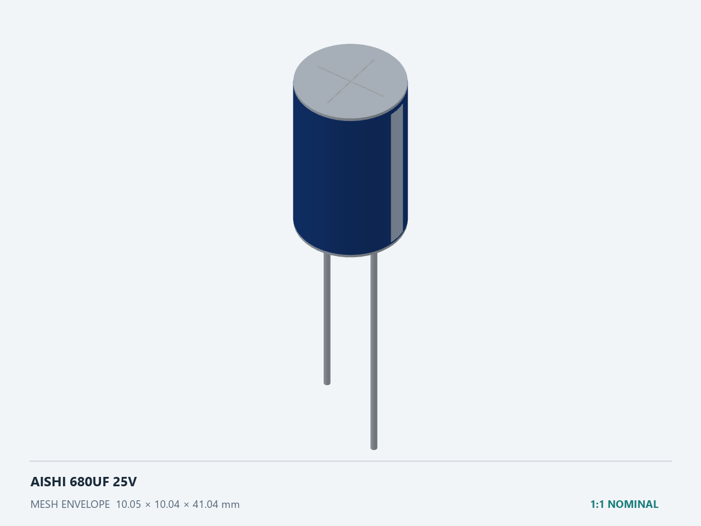
aishi_680uf_25v.png
