yunchencui-hub/DT-smart-system/breadboard_400.png

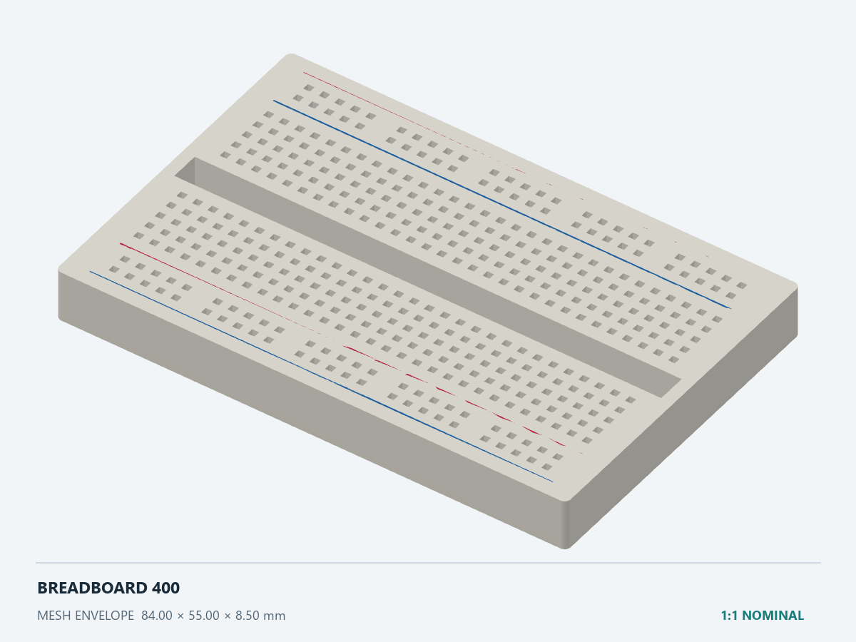
breadboard_400.png
