yunchencui-hub/DT-smart-system/catalog.png

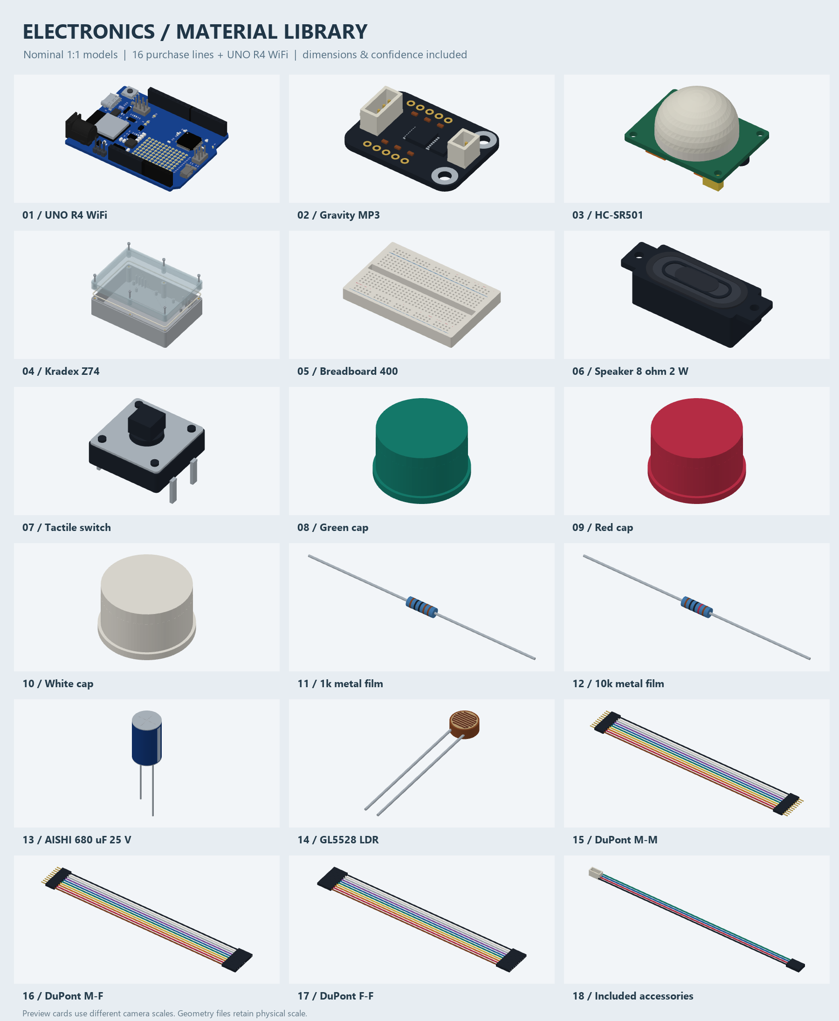
catalog.png
