yunchencui-hub/DT-smart-system/dfrobot_gravity_cable.png

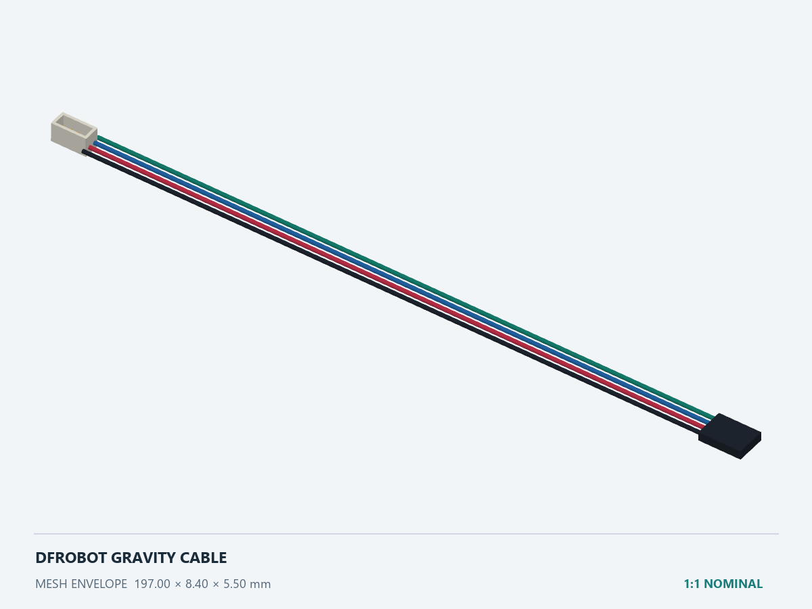
dfrobot_gravity_cable.png
