yunchencui-hub/DT-smart-system/kradex_z74_gasket.png

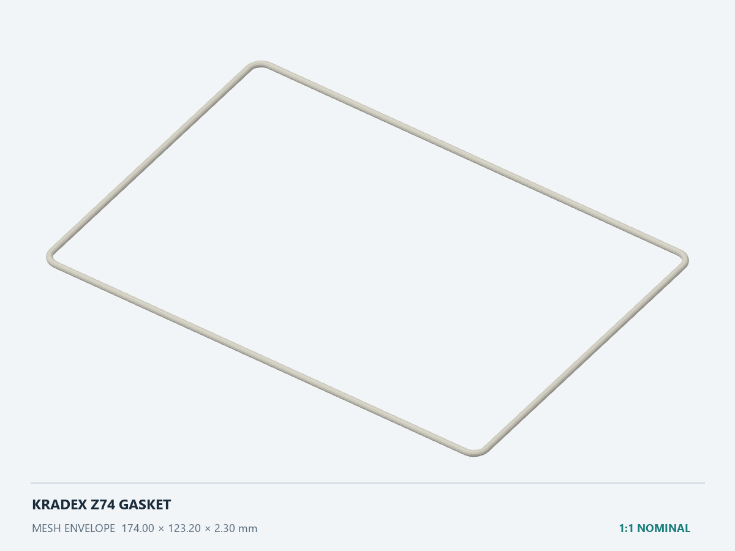
kradex_z74_gasket.png
