yunchencui-hub/DT-smart-system/kradex_z74_lid.png

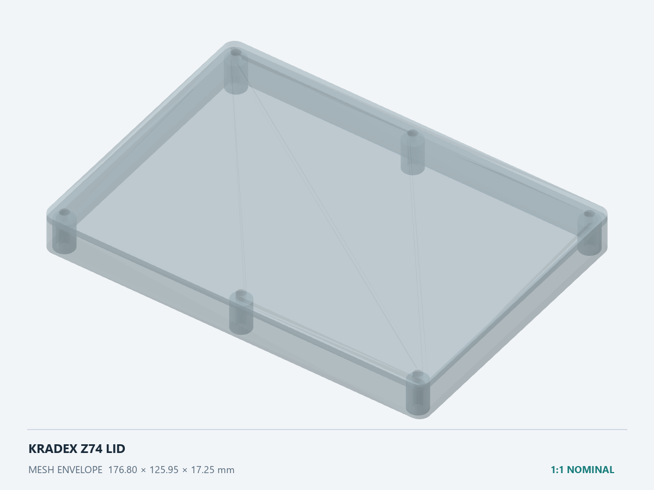
kradex_z74_lid.png
