yunchencui-hub/DT-smart-system/ldr_gl5528.png

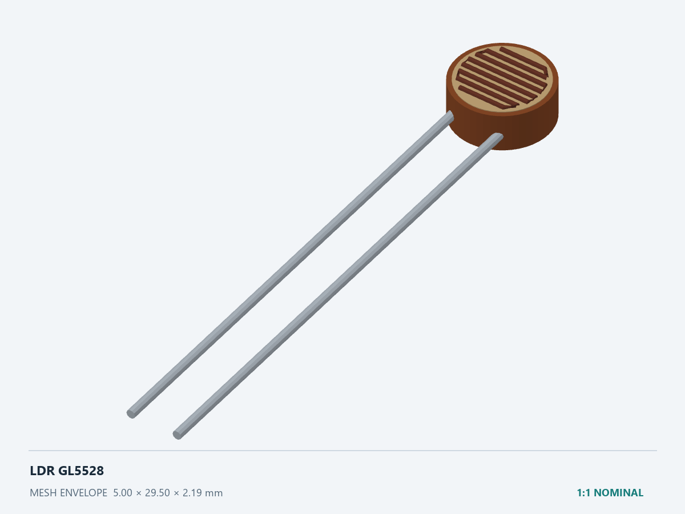
ldr_gl5528.png
