yunchencui-hub/DT-smart-system/tactile_switch_12x12.png

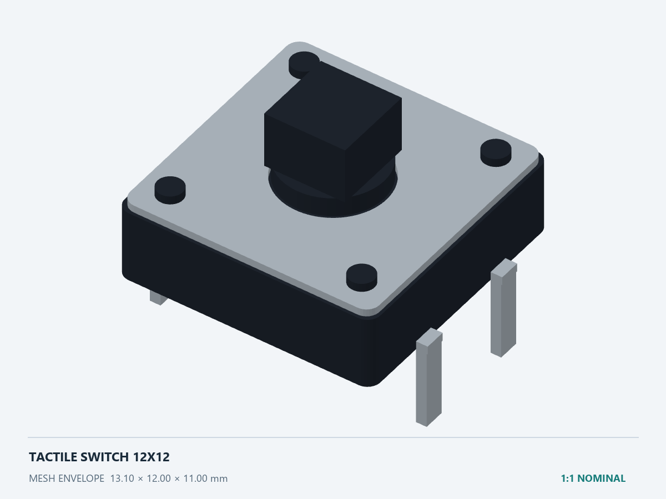
tactile_switch_12x12.png
