yunchencui-hub/DT-smart-system/tactile_switch_with_red_cap.png

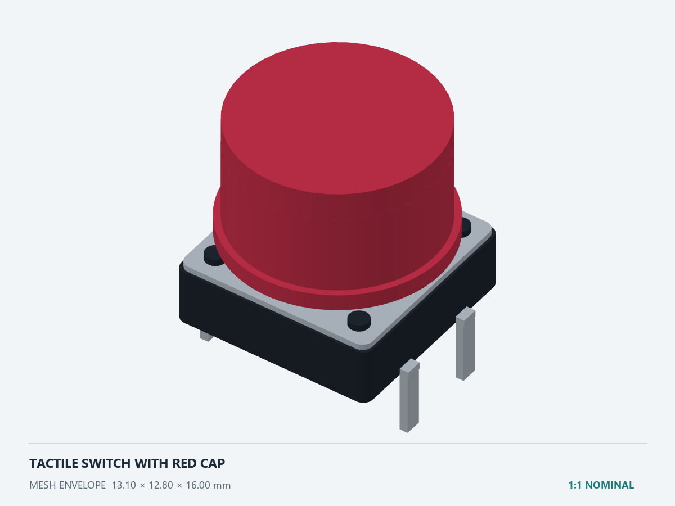
tactile_switch_with_red_cap.png
