yunchencui-hub/DT-smart-system/tactile_switch_with_white_cap.png

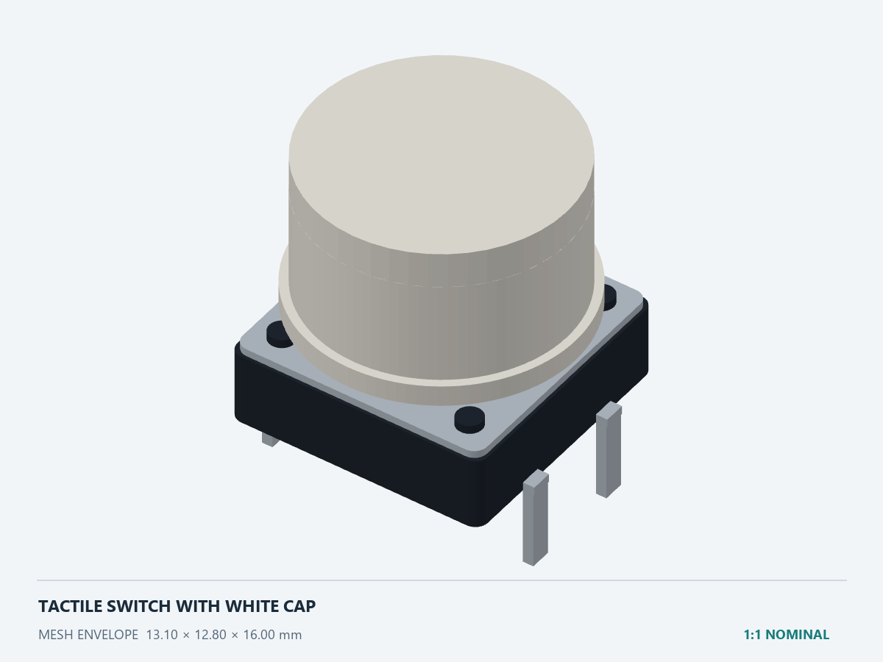
tactile_switch_with_white_cap.png
