yunchencui-hub/DT-smart-system/video-assets/parts/dupont_ff_10wire_ribbon.png

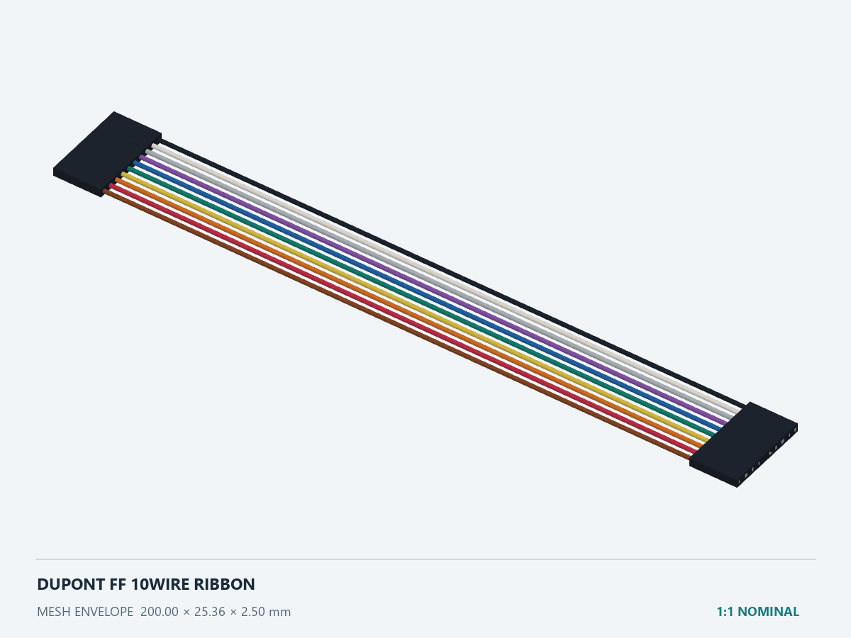
video-assets/parts/dupont_ff_10wire_ribbon.png
