yunchencui-hub/DT-smart-system/video-assets/parts/kradex_z74_exploded.png

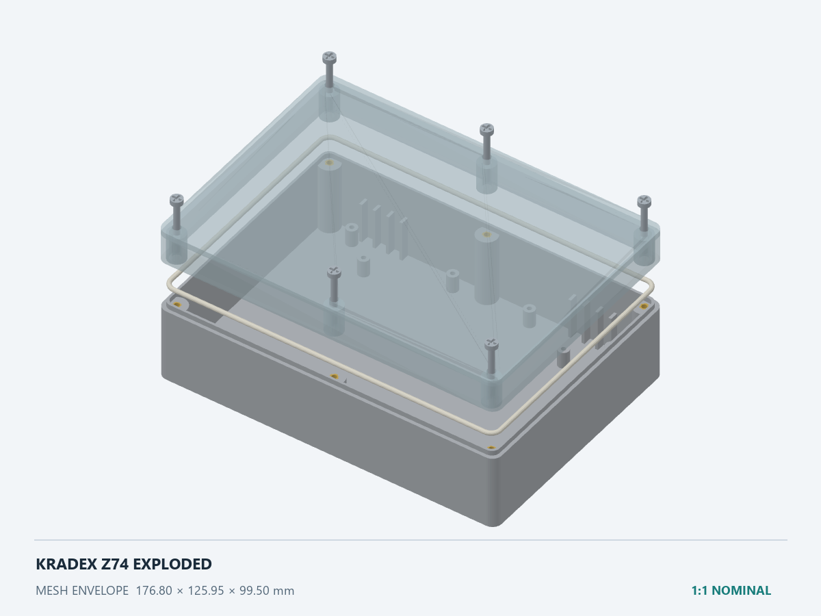
video-assets/parts/kradex_z74_exploded.png
