yunchencui-hub/DT-smart-system/video-assets/parts/speaker_set_with_cable.png

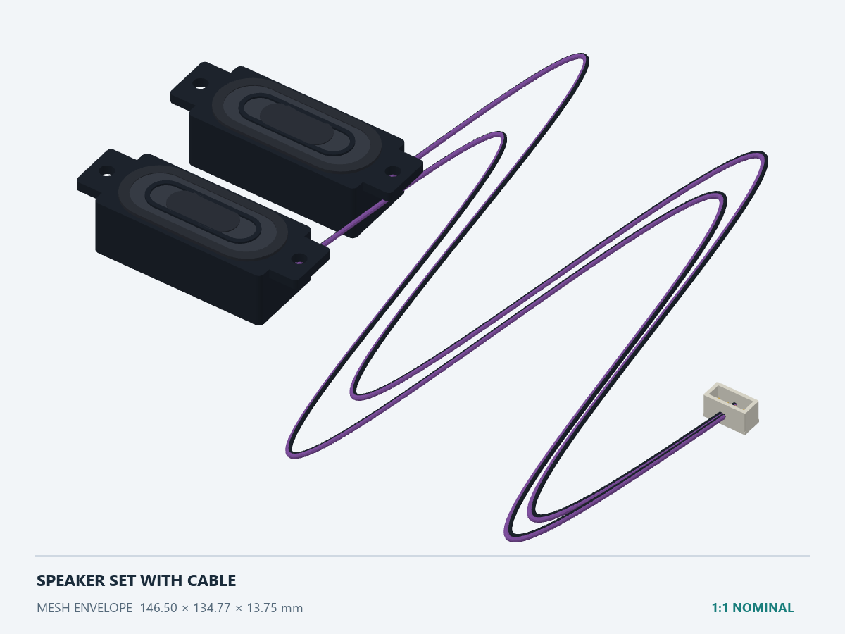
video-assets/parts/speaker_set_with_cable.png
