yunchencui-hub/DT-smart-system/docs/templates/learning_journal.md

# Learning journal: [your name]

> 10 minutes a week. It feeds the reflection section of your Design Notes, and helps you find your learning style (Objective A of the course).

## Week [n], [date]
**What I built / changed:**

**What I learned (explain it in one sentence, as if to a friend):**

**Where I got stuck, and what got me unstuck** (explanation / example / trial-and-error / reading theory):

**Something that surprised me:**

**Confidence per topic (1–5):** hardware _ · networking/MQTT _ · data/SQL _ · ML _ · testing _

**Next week I want to:**

---
## Week [n+1], [date]
...
