yunchencui-hub/DT-smart-system/firmware/robin/face.h

// face.h - Robin's facial expressions on the 12x8 LED matrix of the UNO R4 WiFi.
// Each face is 8 rows x 12 columns; 1 = LED on. Draw your own in the online editor:
// https://ledmatrix-editor.arduino.cc  (then copy the 0/1 grid here).
#pragma once
#include <Arduino.h>

enum Mood : uint8_t { HAPPY, BLINK, TALK, ASK, CONCERN, SLEEP, YES, NO, OFFLINE, MOOD_COUNT };

const char *const MOOD_NAMES[MOOD_COUNT] = {
  "happy", "blink", "talk", "ask", "concern", "sleep", "yes", "no", "offline"
};

const uint8_t FACES[MOOD_COUNT][8][12] = {
  { // HAPPY
    {0,0,0,0,0,0,0,0,0,0,0,0},
    {0,1,1,0,0,0,0,0,0,1,1,0},
    {0,1,1,0,0,0,0,0,0,1,1,0},
    {0,0,0,0,0,0,0,0,0,0,0,0},
    {0,0,0,0,0,0,0,0,0,0,0,0},
    {0,1,0,0,0,0,0,0,0,0,1,0},
    {0,0,1,1,1,1,1,1,1,1,0,0},
    {0,0,0,0,0,0,0,0,0,0,0,0}},
  { // BLINK (eyes closed, still smiling)
    {0,0,0,0,0,0,0,0,0,0,0,0},
    {0,0,0,0,0,0,0,0,0,0,0,0},
    {0,1,1,0,0,0,0,0,0,1,1,0},
    {0,0,0,0,0,0,0,0,0,0,0,0},
    {0,0,0,0,0,0,0,0,0,0,0,0},
    {0,1,0,0,0,0,0,0,0,0,1,0},
    {0,0,1,1,1,1,1,1,1,1,0,0},
    {0,0,0,0,0,0,0,0,0,0,0,0}},
  { // TALK (open mouth)
    {0,0,0,0,0,0,0,0,0,0,0,0},
    {0,1,1,0,0,0,0,0,0,1,1,0},
    {0,1,1,0,0,0,0,0,0,1,1,0},
    {0,0,0,0,0,0,0,0,0,0,0,0},
    {0,0,0,0,1,1,1,1,0,0,0,0},
    {0,0,0,1,0,0,0,0,1,0,0,0},
    {0,0,0,0,1,1,1,1,0,0,0,0},
    {0,0,0,0,0,0,0,0,0,0,0,0}},
  { // ASK (raised eyebrows, small "o" mouth): waiting for a yes/no answer
    {1,1,1,0,0,0,0,0,0,1,1,1},
    {0,0,0,0,0,0,0,0,0,0,0,0},
    {0,1,1,0,0,0,0,0,0,1,1,0},
    {0,1,1,0,0,0,0,0,0,1,1,0},
    {0,0,0,0,0,0,0,0,0,0,0,0},
    {0,0,0,0,0,1,1,0,0,0,0,0},
    {0,0,0,0,0,1,1,0,0,0,0,0},
    {0,0,0,0,0,0,0,0,0,0,0,0}},
  { // CONCERN (worried brows, frown)
    {1,1,0,0,0,0,0,0,0,0,1,1},
    {0,0,1,0,0,0,0,0,0,1,0,0},
    {0,1,1,0,0,0,0,0,0,1,1,0},
    {0,0,0,0,0,0,0,0,0,0,0,0},
    {0,0,0,0,0,0,0,0,0,0,0,0},
    {0,0,1,1,1,1,1,1,1,1,0,0},
    {0,1,0,0,0,0,0,0,0,0,1,0},
    {0,0,0,0,0,0,0,0,0,0,0,0}},
  { // SLEEP (night mode)
    {0,0,0,0,0,0,0,0,0,0,0,0},
    {0,0,0,0,0,0,0,0,0,0,0,0},
    {1,1,1,0,0,0,0,0,0,1,1,1},
    {0,0,0,0,0,0,0,0,0,0,0,0},
    {0,0,0,0,0,0,0,0,0,0,0,0},
    {0,0,0,0,1,1,1,1,0,0,0,0},
    {0,0,0,0,0,0,0,0,0,0,0,0},
    {0,0,0,0,0,0,0,0,0,0,0,0}},
  { // YES (check mark): instant feedback after the green button
    {0,0,0,0,0,0,0,0,0,0,0,0},
    {0,0,0,0,0,0,0,0,0,0,1,0},
    {0,0,0,0,0,0,0,0,0,1,0,0},
    {0,0,0,0,0,0,0,0,1,0,0,0},
    {0,1,0,0,0,0,0,1,0,0,0,0},
    {0,0,1,0,0,0,1,0,0,0,0,0},
    {0,0,0,1,0,1,0,0,0,0,0,0},
    {0,0,0,0,1,0,0,0,0,0,0,0}},
  { // NO (cross): instant feedback after the red button
    {0,0,0,0,0,0,0,0,0,0,0,0},
    {0,0,0,1,0,0,0,0,1,0,0,0},
    {0,0,0,0,1,0,0,1,0,0,0,0},
    {0,0,0,0,0,1,1,0,0,0,0,0},
    {0,0,0,0,0,1,1,0,0,0,0,0},
    {0,0,0,0,1,0,0,1,0,0,0,0},
    {0,0,0,1,0,0,0,0,1,0,0,0},
    {0,0,0,0,0,0,0,0,0,0,0,0}},
  { // OFFLINE (x eyes): no WiFi or no broker
    {0,0,0,0,0,0,0,0,0,0,0,0},
    {1,0,1,0,0,0,0,0,0,1,0,1},
    {0,1,0,0,0,0,0,0,0,0,1,0},
    {1,0,1,0,0,0,0,0,0,1,0,1},
    {0,0,0,0,0,0,0,0,0,0,0,0},
    {0,0,0,1,1,1,1,1,1,0,0,0},
    {0,0,0,0,0,0,0,0,0,0,0,0},
    {0,0,0,0,0,0,0,0,0,0,0,0}},
};

// Returns MOOD_COUNT when the name is unknown.
inline Mood moodFromName(const char *name) {
  for (uint8_t i = 0; i < MOOD_COUNT; i++) {
    if (strcmp(name, MOOD_NAMES[i]) == 0) return (Mood)i;
  }
  return MOOD_COUNT;
}
