yunchencui-hub/DT-smart-system/(commit log)

2026-09-24 Add Robin design docs, roadmap, verified BOM and project memory
    Robin is a routine-aware care robot inspired by Tinybots' Tessa, designed
    for the Digital Designs and Applications course. The docs map each of the
    7 knock-out requirements to a component and a live proof, explain the
    architecture and trade-offs, give a price-checked Tinytronics order
    (EUR 39.00 incl. VAT and shipping), and guide assembly, setup, data
    collection, testing, the 10-minute demo and oral-exam preparation.
    Templates for individual deliverables contain prompts only.
    Claude-Session: https://claude.ai/code/session_01Hm6KxaatYZ2U81kNiAXrek
2026-09-24 Add Arduino UNO R4 WiFi firmware for Robin
    Samples PIR (analog, because of 3.3 V vs 5 V logic levels), LDR and two
    buttons at 10 Hz, publishes 2-second telemetry over MQTT (QoS 0), button
    events with an offline queue (QoS 1), retained status with Last Will, and
    obeys say/ask/face/vol/ping commands. Includes a minimal DFR0534 voice
    driver, LED-matrix faces, and an offline test mode driven from the Serial
    Monitor.
    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
2026-09-26 Add animated build-guide video generator (video/)
    A 32-minute plain-language video, generated from code: the idea, the
    parts, all 8 assembly steps (with the why and a test after each), and
    a day with the finished robot (MQTT, Last Will, storage, Isolation
    Forest, check-ins, alerts), ending with a self-quiz and next steps.
    - engine.js: SVG drawing kit (UNO R4, breadboard with x-ray strips,
    LDR, PIR, buttons, DFR0534, speaker, robot, room) + a seekable
    runtime, so every frame is a pure function of time
    - scenes/: 51 scenes; line timings come from the real narration
    - build.mjs: Piper TTS per sentence -> timeline -> audio mix ->
    Playwright frames -> ffmpeg (1080p24, captions, SRT, chapte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
2026-09-27 docs/03: complete and correct the Tinytronics SKUs
    Every SKU and price was re-checked on the product pages (27 Sep 2026).
    The breadboard's SKU is 000070 (BB400P is only its model code), and the
    white button cap (003058) and the 10k/1k resistor packs (007625/007621)
    now have their SKUs too. CLAUDE.md notes the filled order form and that
    WebFetch can read tinytronics.nl where curl is blocked.
    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
2026-09-30 docs: 30 Sep order (2 W speaker set, 680 uF capacitor, more jumpers) + fix DFR0534 wiring
    The tutor's feedback ("order some more jumper wires; working with speakers
    can be tricky") changed the order form to 16 lines, EUR 35.95 incl. VAT
    (about EUR 42.90 with the parcel):
    - speaker set 8 ohm 2 W with wires (003415) replaces the 1 W speaker
    - male-male jumpers 2 -> 3 packs, male-female 1 -> 2 packs
    - new: 680 uF 25 V electrolytic capacitor x2 (006948)
    docs/04 had a real wiring error: the DFR0534's T/R/+/- are only on its
    white Gravity plug, and the cable that comes with it ends in female
    sockets, so it needs 4 male-male wires (not female-male). Step 5 is
    rewritten around the Gravity cable, th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
    [robin.ino]
2026-10-01 video-remotion: new build-guide video (Remotion) that follows docs/04, pre-review state
    A Remotion (React + TypeScript) project for a narrated build video of
    docs/04 with the 30 Sep parts. Everything the viewer sees and hears is
    generated from data, so the picture, the on-screen tables, the review
    document and the checks cannot disagree:
    - src/script/scenes.ts: every spoken line and on-screen text (36 scenes)
    - src/data/wiring.ts: every wire end and leg with its exact hole
    - scripts/netcheck.ts: electrical check of that wiring (no 5V-GND short
    in any button state, module and capacitor polarity, D1 -> 1k -> R,
    pins = firmware, on-screen pin map and troubleshooting = docs/04,
    order = doc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
2026-10-01 Safety review round 1: fix DFR0534 drawing and wording, no fixing while plugged in
    An independent reviewer agent checked everything the video says and shows
    against docs/04, the firmware and the datasheets. Verdict: FAIL (2 HIGH).
    All findings are fixed, in docs/04 first and then in the video data:
    HIGH
    - "Pull the white plug out of the module": the module has a soldered
    socket, the cable has the plug. Wording is now socket vs plug
    everywhere; in step 5b the cable is simply not in yet.
    - The DFR0534 drawing did not match the real board. Confirmed with the
    datasheet's board photo: Gravity socket T R - +, top holes VCC GND RX TX
    BUSY, bottom holes ONE DACR DACL SP- SP+, and a 2-pin SP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
2026-10-01 Safety review round 2 (PASS): fix the remaining MEDIUM and LOW findings
    Round 2 of the independent review passed (0 BLOCKER, 0 HIGH) with three
    MEDIUM points, fixed in docs/04 first and then in the video:
    - the multimeter beep check moves to 5c/5e, before the capacitor is on
    the rails (an empty capacitor gives a short chirp that could pass for
    a beep); it now asks for a steady beep from the wire's free pin
    - split rails: join red to red and blue to blue, never red to blue
    - soldering safety (glasses, iron stand, hold the wire with tape, let a
    falling iron fall) now comes before the first joint
    LOW: "the module's white socket", SP+/SP- "at the end of the row that
    starts with ONE", unlab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
2026-10-01 video-remotion: safety review round 3 (PASS) and its cosmetic fixes
    - step 2b: the 'column 5' tag no longer covers the bottom rails
    - step 4c: one card at a time, left of the breadboard (13i stays visible)
    - step 5d: speaker wires start at the module's real SP-/SP+ holes;
    micro-USB label below its connector
    - record round 3 in review/safety-review.md; CLAUDE.md status, repo map,
    verify line; video length 24 min in the READMEs
    Claude-Session: https://claude.ai/code/session_017PfaEZfhFqVHhyb1NH6rnv
2026-10-16 video-assets: shot list and privacy rules for the real-footage video
    The new video-assets/images folder is for a video of the complete
    assembly and the tests with the real parts. Its README says what to
    photograph and film while building (follows docs/04 step by step,
    including each ✅ test, plus the docs/08 demo and the duo's own test
    cases), how to name the files, which phone settings to use, and how to
    upload within GitHub's limits.
    The repository is public, so the README also covers privacy: turn off
    GPS location in phone photos, and keep the WiFi secrets, the ntfy topic
    and faces out of shots. CLAUDE.md records this as a lesson, adds the
    folder to the repo map and updates Status; READ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
2026-10-18 video-remotion: anatomy + ELI5 build video (RobinAnatomyBuild)
    The assembly of docs/04, step by step, as isometric figures drawn with the
    anatomy skill's kit and narrated in plain words (ELI5): 16 chapters, 16.8 min.
    - src/anatomy/kit/iso-kit.ts: the anatomy skill's core, vendored unchanged
    (MIT, github.com/wheresryan22/anatomy at 1482e84, licence alongside).
    - The bench is built in 3D from the real part sizes; every hole and pin comes
    from src/data/wiring.ts, so netcheck (369/369) and the cable rules R1-R5
    check this video as well. Parts drop in as the narrator names them; only
    the part being added glows; rails, columns and pins light up on the board.
    - Explainer figures: breadboar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
2026-10-19 video-remotion: anatomy + ELI5 debug guide (RobinAnatomyDebug)
    A second anatomy video on the same 3D bench: how to find and fix the
    mistakes the troubleshooting tables in docs/04 and docs/05 name, as a
    doctor's routine (symptom, unplug, look and measure, fix, test again).
    - src/anatomy/debug/: script (15 scenes, 11 cases), figures (button
    x-ray, network stations, MP3 drive), own entry point and composition.
    - src/anatomy/faults.ts: the wrong wiring drawn per case, kept apart
    from wiring.ts so netcheck only checks the real build.
    - IsoVideo.tsx (was AnatomyBuild.tsx) + video.ts: one player for both
    anatomy videos via makeVideo(); the build video renders unchanged.
    - scripts/videos.ts: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
2026-10-19 Debug guide: fixes from an independent 5-lens review
    A review (safety, hardware, firmware match, docs match, ELI5) with a
    skeptic per finding confirmed 32 problems (11 refuted). Fixed:
    - Serial Monitor as the firmware really prints it: the start message
    has "[queue] events waiting: 1"; "[tx-failed]" every 2 s is normal in
    offline test mode (explained in the tools scene and case 11); raw is
    a 2-second snapshot, so every test types raw again after a re-plug.
    - PIR: an HC-SR501 stays HIGH for seconds, so case 3 shows runs, not a
    flip on every line; case 3 gets its own unplug step and the Sx
    direction; case 4 waits the 60 s warm-up and names jumper H.
    - Safety: the no-sound file check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
2026-10-19 Debug guide: show Robin's face when the tools scene names it
    The face line was spoken over the UNO view, where the 8.5 mm front
    header hides the LED matrix. A line can now set faceCard: the FACE card
    takes the Serial Monitor's place for that one line, so the X eyes are
    on screen while they are named and the Serial lines stay readable in
    the rest of the scene. The build video's scene-wide FACE card is
    unchanged.
    Claude-Session: https://claude.ai/code/session_01Tknzt9fS3KbGUK7WiqcBba
2026-10-19 Debug guide: review record, README and CLAUDE.md status
    - review/debug-review.md: the independent 5-lens review, every
    confirmed finding with what changed, and the refuted ones with why.
    - README: 14 min, the review, R3 in the debug guide, where the Serial
    Monitor lines come from.
    - CLAUDE.md: status and a lesson on what robin.ino really prints.
    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
2026-10-27 Add a setup checker for the user's laptop (docs/05 A-D)
    backend/check_setup.py compares a computer with docs/05_software_setup.md
    and prints OK / WARN / FAIL / INFO per step, with the section to read.
    Standard library only, so it also runs before pip install has worked.
    - A: Arduino IDE 2, UNO R4 board package, ArduinoMqttClient, the
    arduino_secrets.h rules (placeholder, eduroam, localhost, laptop IP,
    device id, .h.txt names) and a real compile with the IDE's arduino-cli
    - B: venv, Python >= 3.11, packages vs requirements.txt, config.yaml,
    pytest, simulator data and model metadata
    - C: Mosquitto, installer service on port 1883, broker answering on
    localhost and on the LAN IP (tiny M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
2026-10-28 Fix setup issues found while installing on Windows
    Found by setting up the user's Windows 11 laptop and two rounds of
    independent review:
    - firmware: WiFi.RSSI() never starts the WiFi chip, so in offline test
    mode every telemetry cycle waited the 10 s modem timeout and loop()
    froze (buttons, faces, Serial). Read RSSI only when online.
    - backend: models are now per device (models/anomaly-{device}.joblib).
    The brain refuses a model trained on another device, so a simulator
    dry run can no longer drive the real robot's check-ins and caregiver
    pushes, and train refuses to overwrite another device's model (old
    configs with one shared path). Simulator reports and latency CSVs go
    to r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
2026-10-28 Wait for a valid IP before MQTT; check_setup finds per-device models
    - firmware: after WiFi.begin(), wait up to 20 s for the connection and retry
    when the board still reports 0.0.0.0, so MQTT is not tried without an
    address. This was the user's own change, uncommitted on the laptop.
    - check_setup.py: read the model through config.model_file(), so the
    per-device path (models/anomaly-{device}.joblib) is checked, not the
    literal {device} name.
    52 tests pass. The firmware compile was not run here (no arduino-cli in
    this session): compile in Arduino IDE 2 before uploading.
    Claude-Session: https://claude.ai/code/session_018MndmcJv55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
2026-10-29 Ignore the UNO R4 WiFi firmware updater folder
    unor4wifi-update-windows/ holds Arduino's connectivity-firmware updater
    (espflash.exe, unor4wifi-reboot.exe, UNOR4-WIFI-S3-0.6.0.bin, ~12 MB).
    It sits in the repo root on the laptop and was untracked but not ignored,
    so a "git add ." would have pushed third-party binaries to the public repo.
2026-11-08 Voice module: play "/NN*MP3", add probe and playnum debug commands
    The DFR0534 play-by-name path now ends in the extension, following the
    8+3 rule of the codingABI/DFR0534 library. New Serial commands: probe
    asks the module for its drives, file count and play state, and playnum
    plays a file by copy order. On the real module this showed power,
    wiring and the 13 files were fine and the module was playing, so the
    silence was the speaker connection. docs/04 step 5d and the "No sound"
    row now start with probe. Firmware 1.0.1.
